adept-anyball/mod/README.md

#  Adept Anyball

[Ploopy Adept](https://ploopy.co/adept-trackball) mod for 8 mm BOSCH Rexroth <a href='#btus-needed'>BTUs</a> with optional <a href='#magnets'>magnetically</a> attachable buttons. \
Various adapters are available, making it possible to use not just BTUs but also default ball bearings, static bearings. 



## Compatibility<sup>\*</sup>

| Ball | | |
| --- | --- | --- |
| 34 mm, 38.1 mm | ✔️  | e.g. Perixx, original Ploopy Nano ball; see [this repo](https://github.com/adept-anyball/ploopy-adept-small-btu) |
| 44 mm | ✔️  | e.g. from ProtoArc, JOMAA |
| 45 mm | ✔️  | default Adept ball |
| 50.8 mm | ✔️  | english pool ball, from Adesso T50 |
| 52.4 mm | ✔️  | snooker ball |
| 55 mm | ✔️  | e.g. from Kensington Expert, Perixx |
| 57 mm | ✔️  | pool ball |
| 60 mm | ✔️  | pool ball |
| 68 mm <sub>?!</sub> | ✔️  | russian<sup>\*\*</sup> pyramid ball |

<sup>\*chances are your ball is compatible if it's within the \[min, max\] range, and it probably is.</sup> \
<sup>\*\*kindly consider [supporting Ukraine](https://u24.gov.ua) to fight Russia in the ongoing invasion and occupation.

## General tips

> ❗️ **Important!** \
> \
> Use STL (not STEP) files for Slic3r forks, i.e. Prusa-, Orca-, Bambu Slicer. 
> STEPs are for CADs. There has been many cases reported when a STEP file has caused invalid geometry, 
> including critical changes such as "no gap between button and shell".

### Printing

1. There MUST be no supports, unless you really know what you are doing.

2. PLA, PETG, ABS — any of those are fine. 

### Other

1. Insert magnets on a flat hard surface while the device is not assembled.

2. Cyanoacrylate (superglue) works nice for magnets.

3. If you experience buttons sticking, try loosening the screws or removing the sensor cover.

4. If you experience bad tracking, you may want to print and install spacers.

## 57-68 mm ball (or 50-60 mm with spacers installed)

<p>
  
  
</p>

## 50-55 mm ball

Also available for non-standard BTUs: 
[SP-8](https://github.com/adept-anyball/mod/issues/5), [Veichu-15](https://github.com/adept-anyball/mod/issues/11).

> If you use CY-8H Aliexpress BTUs, it is recommended to go with the 50-52.4mm version instead. \
> You can ignore the fact that it is deprecated in such a case. \
> That version (in combination with this BTUs) should work with a 55 mm ball too.

<p>
  55mm ball
  55mm ball
</p>

## 50-55 mm ball (short version)

Fits a 50-55 mm ball. In this mod, the bottom and top parts of the original Adept case have been modified.

<p>
  55mm short top
  55mm short side
</p>

## 50-55mm ball (short, thin bezel)  
Fits a 50-55 mm ball. In this mod, the bottom and top parts of the original Adept case have been modified.  
It was built based on the short version above.
<div style="display: flex; justify-content: space-between; align-items: center;">
  Side View
  Close-up View
</div>

## 44-45 mm ball

This mod fits the original 45mm ball. \
You can find the 3MF files for Bambu printers on [Makerworld](https://makerworld.com/en/models/1087275#profileId-1080219).

<p>
  45mm top
  45mm top without ball
</p>

## 50-52.4 mm ball _DEPRECATED_

> The shell is deprecated, see 50-55mm one. It has standard size buttons and better BTUs placement.

<p>
  
  
</p>

## BTUs needed

[This is the link](https://store.boschrexroth.com/BALL-TRANSFER-UNIT_R053010810) to genuine BOSCH Rexroth BTUs.  
Also available on [efog.tech](https://efog.tech/products/bosch-rexroth-btu). 

<p>
  BTU specsheet
</p>

[EFOG.TECH® BTUs](https://efog.tech/products/efogtech-btu) are fully compatible.  
CY-8H BTUs from AliExpress [are compatible](https://github.com/adept-anyball/mod/issues/6), with one exception so far. \
[SP-8](https://github.com/adept-anyball/mod/issues/5) and [Veichu-15](https://github.com/adept-anyball/mod/issues/11) are not directly compatible, but there are model(s) available. \
Rexroth BTUs are clearly superior and are highly recommended.

## Magnets

You will need 4x2 mm circular neodymium magnets, full set (device + buttons) is 24pcs. \
They MUST be glued, ideally with a cyanocrylate based glue. 

## Quality Assurance

We have the best of the best.



## Even more photos

See [gallery](https://github.com/adept-anyball/mod/issues/7).
