adept-anyball/mod/adapters/IS-05SNM.stl

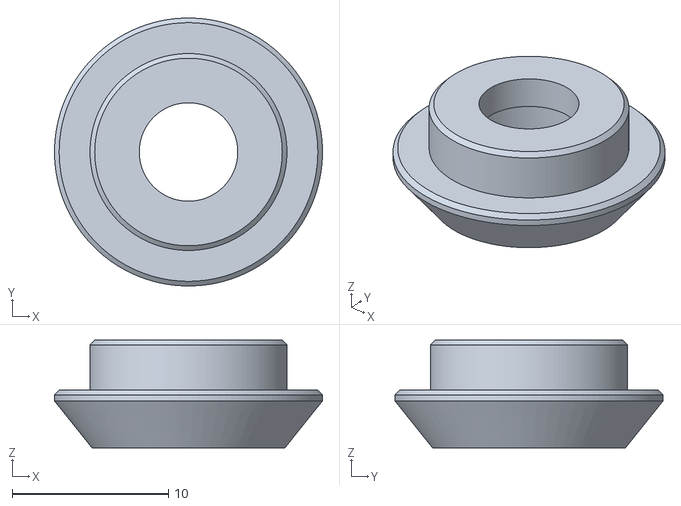
[picture p1: CAD file, 2026-11-09]
adapters/IS-05SNM.stl
17.1 x 17.1 x 6.90
