adept-anyball/mod/(threads)

Thread 4 (2025-02-18):

Veichu-to-Rexroth adapter

efogdev, 2025-02-18:
## ToDo

NayteDog, 2025-03-01:
Just got my parts in today, and I'm still waiting for other bearing to ship, but had these ones on hand. I'm using the 57-68mm mod with a pool ball and I don't think these bearings are gonna cut it for such a heavy ball. When swiping the ball around normally they seem to get stuck quite a bit. I wouldn't recommend using them on the larger sizes, but the adapters did work perfectly.

efogdev, 2025-03-01:
Thank you for the feedback! Really appreciate it. Please share a photo under "gallery" issue when it's done!

Thread 5 (2025-02-18):

Check Aliexpress BTUs for compatibility

efogdev, 2025-02-18:
Link: [https://vi.aliexpress.com/item/1005007460320866.html](https://vi.aliexpress.com/item/1005007460320866.html)

efogdev, 2025-02-18:
I'm currently waiting for them to arrive.

efogdev, 2025-02-27:
SP-8 nylon ball: https://github.com/user-attachments/assets/d8cfdc46-2cf6-4129-a199-c57a8b72ef77
SP-8 steel ball: https://github.com/user-attachments/assets/b1ad3f8a-16da-45e3-a90e-de85919935fa
Rexroth for comparison: https://github.com/user-attachments/assets/21eb35c5-aafb-43b8-8942-3b341e5ec625

benmccown, 2025-03-06:
Just got my SP-8s in the mail today. Going to try printing the alternate top, will update on how it goes.

I watched the videos you shared. As someone who doesn't have Rexroth BTUs to compare against, how big of a quality difference do you notice?

HuyLeKouta, 2025-03-07:
I have seen the showcase

So the SP-8 BTU can be used in the newer 50-55mm shell ?

Thanks for the re-confirmation

efogdev, 2025-03-07:
@benmccown speaking of the steel ball version, it's honestly almost the same. I'd say Rexroth still feels better in long run, maybe just more stable? Not sure.

@HuyLeKouta yes

benmccown, 2025-03-07:
@efogdev So I printed the SP8 compatible top and I'm trying to use it with my 52.5mm snooker ball, but it seems to be sitting way too high off the sensor to detect any mouse movement. It looks like mine sits a good bit higher than the example videos you've attached in the original issue comment.

Any ideas if I've set anything up incorrectly? What ball size did you use in that original example?

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

benmccown, 2025-03-07:
@efogdev Got it fixed up. The issue was the sensor cover along with me not realizing how hard you have to push the BTUs into the sockets to seat them. I had to get some sandpaper out so I could make more room to actually push them down.

efogdev, 2025-03-07:
@benmccown glad you got it working! Yes, the tolerances are really tight, but it should be like that, because it would be really loud otherwise.

efogdev, 2025-03-07:
Also, I assume you need the sensor cover? I'll make it soon and will update you

efogdev, 2025-03-08:
Actually I just realized you probably can grab the sensor cover from the "57-68mm ball" version, and it will probably be fine.

benmccown, 2025-03-08:
@efogdev I actually just used the sensor cover from the "Everything" file for the 50-55mm. Maybe that's why it was so tight?

efogdev, 2025-03-08:
Yeah it's not supposed to be used with that cover, I'd recommend to print the one I've mentioned above. I probably should make it more clear in the README.

JayBee-git, 2025-03-28:
Sadly the 57-68mm sensor cover doesn't really work, it's way too small so it's just floating there moving around, not attached to anything.
I got another weird issue with the SP8 top, I fully inserted the BTUs, but somehow the ball doesn't go right to the bottom, the left BTU looks like it's too high making the left gap bigger. Might just be a tolerance issue, but visually both BTU look completely inserted.
@efogdev Would it be alright to share a STEP file with us so I can tweak it a little? Thanks a ton.

efogdev, 2025-03-29:
Damn, I didn't know I forgot to upload a STEP for this one. The thing is, I also forgot to make a checkpoint in the CAD :D
I will probably have to make this one again (not that it make much time but still), I'll ping you then

benmccown, 2025-04-29:
@efogdev I went to print the updated SP8 top housing and it looks like you have the sensor cover included in the file and not as a separate body. Unfortunately the print failed because the sensor cover tried to print with the body and the overhang angle is too high.

efogdev, 2025-04-29:
@benmccown yep that's right, I just thought it'll be a mess if I start to include sensor covers and everything else as separate files. You're supposed to split those in your slicer (the same applies to the main model), I'm not sure how to make it more clear in README

benmccown, 2025-04-29:
@efogdev got it, thanks mate. sorry for the confusion. I just got a new printer (Bambu P1S) and so it's my first time using the Bambu slicer, and the file shows up as one body so I was confused and thought it wasn't splittable. Let me do some more learning with the slicer and see if I can split it.

j1n6, 2025-05-17:
@efogdev possible to make a thin/short version of this?

efogdev, 2025-05-17:
@j1n6 possible but would take fair amount of work.

j1n6, 2025-05-17:
> @j1n6 possible but would take fair amount of work.

Hope you may have sometime to work on it - this is slightly outside my knowledge...

Thread 7 (2025-02-19):

Gallery

efogdev, 2025-02-19:
You're welcome to show your Anyball here!

efogdev, 2025-02-20:
50-52.5mm version vs 50-57mm side-by-side comparison.

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

NayteDog, 2025-03-01:
57-68mm mod with a pool ball
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

benmccown, 2025-03-07:
50-55mm with SP8 BTU compatible top housing, with a 52.5mm snooker ball. I've combined it with [the AdeptBLE](https://github.com/taichan1113/AdeptBLE) project so it's bluetooth running ZMK. I'm going to have to reprint the top housing because I had some warping issues during printing that don't impact functionality, but will also bother me as a perfectionist :). [Build details on Reddit here](https://www.reddit.com/r/ploopy/comments/1j62mwi/wireless_bluetooth_ploopy_adept_adeptble_with_a/). More pics [here](https://imgur.com/a/TYVjxkV).

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

pandrr, 2025-03-08:
45mm ball / rexroth BTU

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

pingjocky, 2025-03-15:
57-68mm mod with a pool ball

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

yuhua99, 2025-04-24:
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
works beautifully with sp8 btu, great job @efogdev

zodduska, 2025-07-19:
55mm short thin bezel in FDM .12 PLA

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

Thread 8 (2025-02-22):

Rexroth to static bearings adapter

fabriciobastian, 2025-02-22:
Create an adapter from Rexroth to Si3N4 (silicon nitride) or ZrO2 (zirconium oxide) bearings.
I think that a 3mm ball would be the ideal size.

efogdev, 2025-03-17:
Available here: https://github.com/adept-anyball/mod/tree/master/adapters
Supported ball diameter: 3-3.5 mm

https://github.com/user-attachments/assets/ae486861-e14f-4753-9ae3-77dcdf996d90

Thread 10 (2025-03-07):

Tolerance issues for BTU sockets and magnet sockets

benmccown, 2025-03-07:
Hey there! With my recent build, using the SP8 top housing 50-55mm, I couldn't get the BTUs to fit without sanding each hole for 3-5 minutes each. I went to superglue my 4x2mm magnets and ran into the same problem- they wouldn't fit. I just superglued the buttons to the top instead of using magnets.

I do plan on reprinting the top housing sometime soon because I had print warping issues. Going to tune my printer up and try again. But I'm wondering if there's any way we could get a 0.1mm or 0.2mm tolerance bump for the areas I've mentioned? Especially the magnets, since they don't really need to be perfectly tight if you're using superglue anyway.

Everything was printed on an Ender 3 using standard PLA, 205 C nozzle temp, 0.2mm layer height, and default Prusa slicer settings for the Ender 3. Since I'm running a cheaper printer I'm guessing that may be the issue, but I'm sure others out there will want to build this project and might not have a top of the line Prusa or something.

Thanks for an awesome project.

Cheers,
Ben

efogdev, 2025-03-08:
Hey, thanks for the feedback. You're not the first one mentioning that problem, so yeah, I will eventually rework all the shells.

Actually (for those who maybe waiting), that's pretty easy to do with 3 clicks in OnShape — you just import the STEP, use "move face" tool with like 0.1-0.2mm value, then apply and export.

benmccown, 2025-03-08:
I will give it a shot! Thanks for the tip. Will give you an update when I try it (probably in a few days).

efogdev, 2025-03-08:
I just tried that and apparently it's not the case for this model :( "move face" doesn't work with this particular face because of... reasons.

But I of course have the full features history so won't be an issue. I'll update you in this ticket in several days, ping me in case I forget :)

fabriciobastian, 2025-03-08:
I would also suggest that you run a calibration on your printer, if you haven't done so. The magnet holes have a .2 tolerance, which is a full layer. It should be enough for them to at least fit tightly.
You could also check whether there are seams on the holes and if you can print without putting seams on the magnet holes.
Otherwise, I guess that we could add another .1mm tolerance to the hole diameters @efogdev.

efogdev, 2025-03-09:
@fabriciobastian I remember us talking about making it 4.35mm :)

fabriciobastian, 2025-03-10:
@efogdev that works too :)

JayBee-git, 2025-03-26:
Yeah I got the same issue, most 4x2 magnets we can find are 4.15~4.2mm and not exactly 4, meaning even with a well calibrated printer, the tolerance is still too tight.
It sadly a common issue with these magnets. I had to increase the size of mine to 4.5 with a rotary tool.
Indeed I'd love models with 4.35~4.5mm holes too :)

efogdev, 2025-03-26:
I'm too excited to work on [the wirelessifier](https://github.com/efogdev/wirelessifier) because I got the rev.02 PCBs on hands yesterday 😅

But I promise I'll do the changes once my internal hype goes away!

JayBee-git, 2025-03-27:
It's alright I completely understand. Do you have a step file or similar? I could do it on my side if you want and share the file, not an issue for me 👍

Thread 11 (2025-03-15):

Veichu-15 BTU compatibility

efogdev, 2025-03-15:
# SP-8

For example, [this](https://vi.aliexpress.com/item/1005005528750648.html) ones.
15 mm refers to the outer diameter in this case.

# Knowledge base

**Compatibility**: ❗️not compatible, separate model(s) available
**Differences**: ❗️TBD
**Comments**: no builds yet.

# Links

50-55 mm shell here: https://github.com/adept-anyball/mod/tree/master/50-55mm%20ball

# Showcase

Rexroth for comparison: https://github.com/user-attachments/assets/d8cfdc46-2cf6-4129-a199-c57a8b72ef77
Veichu-15 POM ball: TDB
Veichu-15 steel ball: TDB

Thread 14 (2025-03-17):

Adapter for static bearings

efogdev, 2025-03-17:
Available here: https://github.com/adept-anyball/mod/tree/master/adapters
Supported ball diameter: 3-3.5 mm

https://github.com/user-attachments/assets/ae486861-e14f-4753-9ae3-77dcdf996d90

Closed 2025-03-17.

Thread 15 (2025-03-21):

BOM for AdeptBLE PCB Assembly

leclaron, 2025-03-21:
Here is the BOM for getting the PCB for the AdeptBLE assembled from factories like PCBway and JLCPCB, I have picked components that are possibly the cheapest options available from suppliers like Mouser and Digikey.
The only thing not included in this BOM is the Seeeduino Xiao NRF as it isn't possible to have it soldered to the PCB at the factory.

[AdeptBLE BOM.ods](https://github.com/user-attachments/files/19398146/AdeptBLE.BOM.ods)

efogdev, 2025-03-22:
Hey, I'm not sure how this is relevant to Anyball; anyways, I think it makes sense to create not an issue but a discussion

efogdev, 2025-03-22:
I've nothing against this info being in this repo, it's useful for Adept owners. But it would be great if you could create a discussion instead (issues isn't quite the right place IMO)

Closed 2025-03-22.
